Laxilef/GasholderMon/assets/6320S.pdf

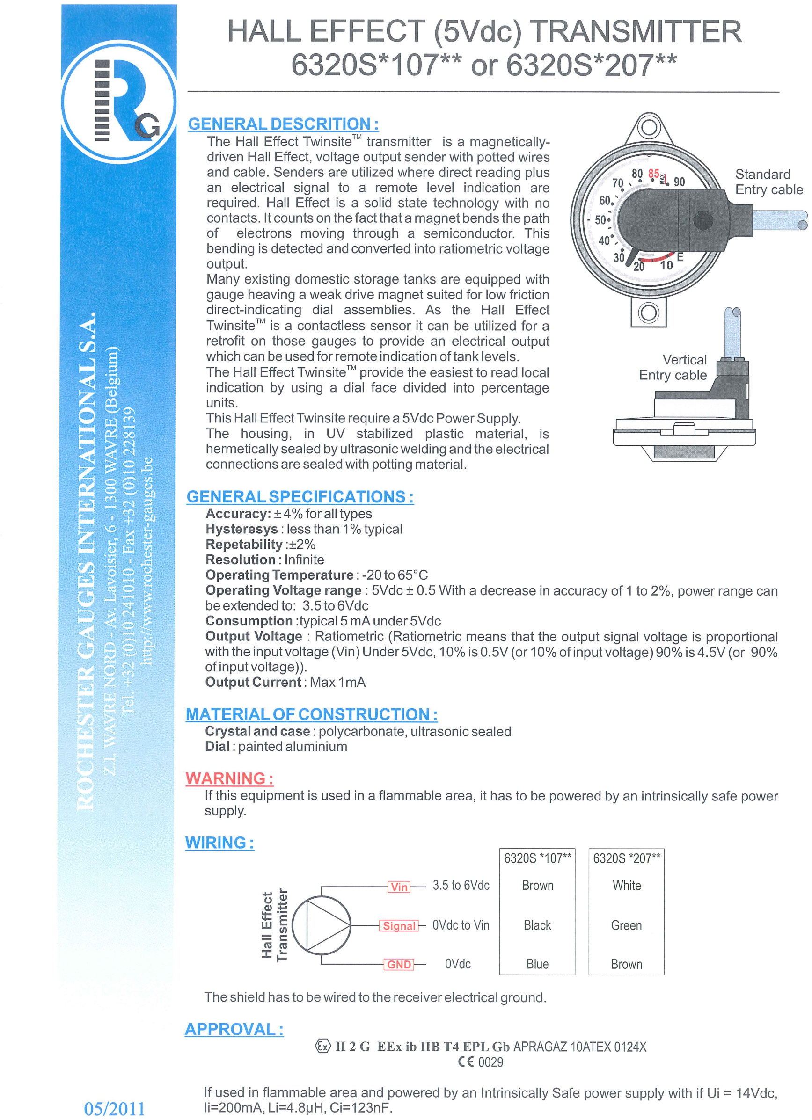
[picture p3: page 1]
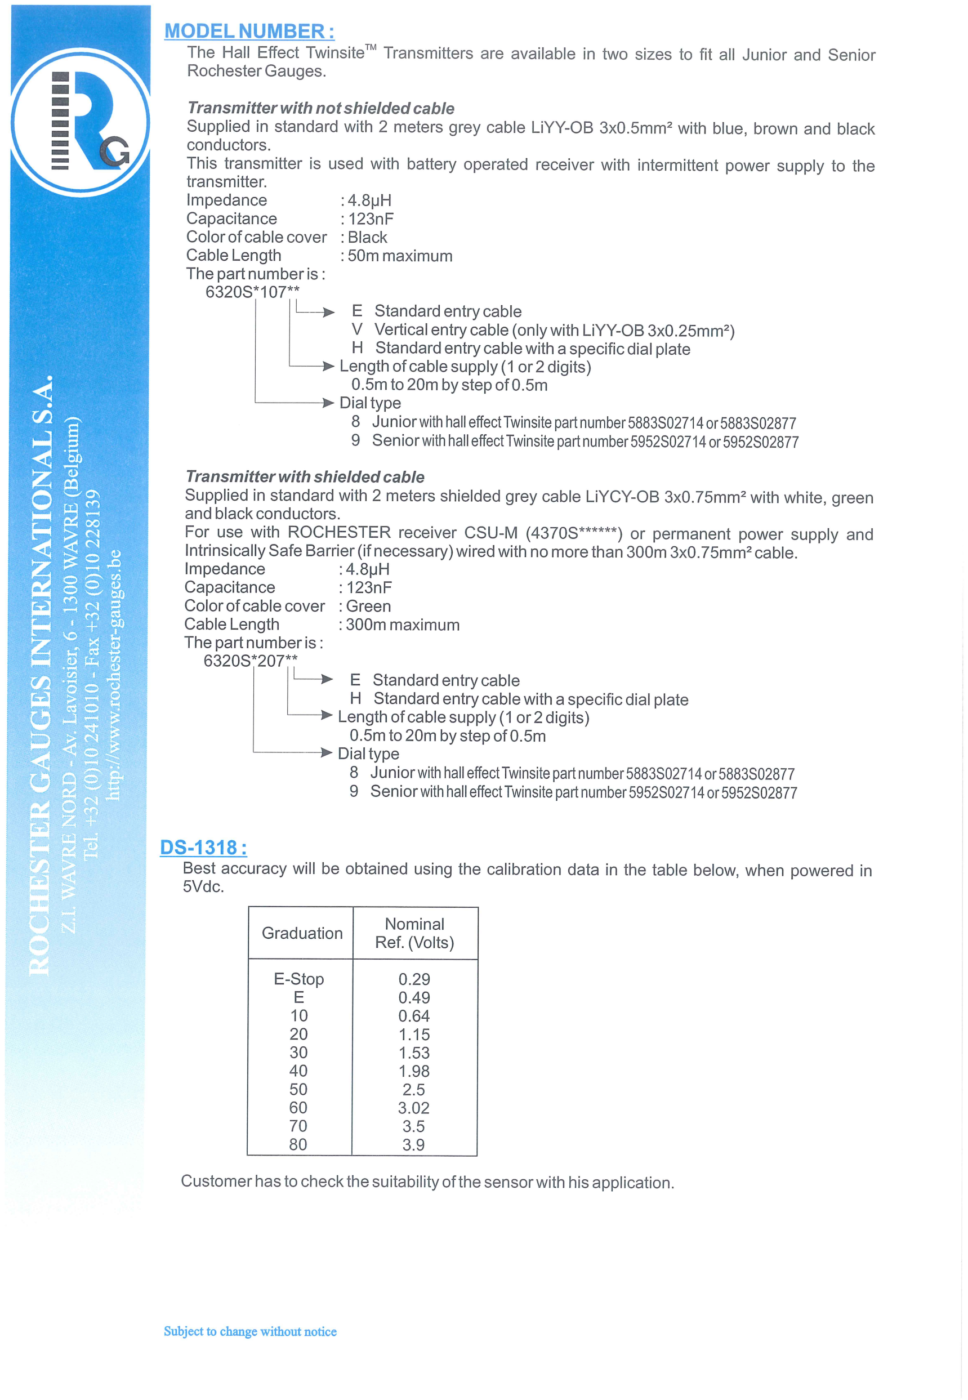
[picture p4: page 2]
