Laxilef/GasholderMon/assets/BOM.xlsx

ID | Name | Designator | Footprint | Quantity | Manufacturer Part
1 | 100uF | C1 | CAP-SMD_BD6.3-L6.6-W6.6-LS7.2-FD | 1 | RVT1C101M0605 | https://www.chipdip.ru/product0/9000565735
2 | 100nF | C2,C4,C5,C6,C7 | C0805 | 5 | GRM21BR71H104KA01L | https://www.chipdip.ru/product/grm21br71e104ka01l
3 | 22uF | C3 | CAP-SMD_BD5.0-L5.3-W5.3-LS6.3-FD | 1 | RVT1V220M0505 | https://www.chipdip.ru/product0/9000565721
4 | 0.5A | F1 | FUSE-7.4*4.5-5.1MM | 1 | TRC025 | https://www.chipdip.ru/product/vp4-1-0.5a
5 | MF-MSMF110/16-2 | F2 | F1812 | 1 | MF-MSMF110/16-2 | https://www.chipdip.ru/product0/8010600635
6 | MF-USMF005-2 | F3,F4 | F1210 | 2 | MF-USMF005-2 | https://www.chipdip.ru/product0/8003673517
7 | LED0805 | L1,L2,L3 | LED0805-RD | 3 | led0805 | https://www.chipdip.ru/product/to-2013bc-pg
8 | BSS138 | Q1,Q2 | SOT-23-3_L2.9-W1.3-P1.90-LS2.4-BR | 2 | BSS138 | https://www.chipdip.ru/product/bss138-umw
9 | IRLML5103TRPBF | Q3 | SOT-23_L2.9-W1.3-P1.90-LS2.4-BR | 1 | IRLML5103TRPBF | https://www.chipdip.ru/product/irlml5103trpbf-hottech
10 | 10k | R1,R2,R3,R4,R5,R6,R7,R8 | R0805 | 8 | 10kΩ | https://www.chipdip.ru/product/0.125w-0805-10-kom-1
11 | 100 | R9 | R0805 | 1 | 100Ω | https://www.chipdip.ru/product/0.125w-0805-100-om-1
12 | 1K | R10,R11,R12 | R0805 | 3 | RC0805FR-071KL | https://www.chipdip.ru/product/0.125w-0805-1-kom-1
13 | HLK-PM01 | U1 | PWRM-TH_HLK-PM01 | 1 | HLK-PM01 | https://www.chipdip.ru/product0/8000358621
14 | AMS1117-3.3 | U2 | SOT-223-3_L6.4-W3.5-P2.30-LS7.0-BR | 1 | AMS1117-3.3 | https://www.chipdip.ru/product/ams1117-3.3
15 | ADS1115IDGSR | U3 | MSOP-10_L3.0-W3.0-P0.50-LS5.0-BL | 1 | ADS1115IDGSR | https://www.chipdip.ru/product/ads1115idgst
16 | 300-021-1x | U5,U6 | ALMAS-SCREW-TERMINAL-300-021 | 2 | 300-021-12 | https://www.chipdip.ru/product/dg300-5.0-02p-12
17 | 300-031-1x | U7 | ALMAS-SCREW-TERMINAL-300-031 | 1 | 300-031-12 | https://www.chipdip.ru/product/dg300-5.0-03p-12
18 | B72210S2511K101 | VAR | RES-TH_L12.5-W8.0-P7.50-D0.8-S3.10 | 1 | B72210S2511K101 | https://www.chipdip.ru/product/b72210-s251-k101
