Laxilef/GasholderMon/assets/sheet.pdf

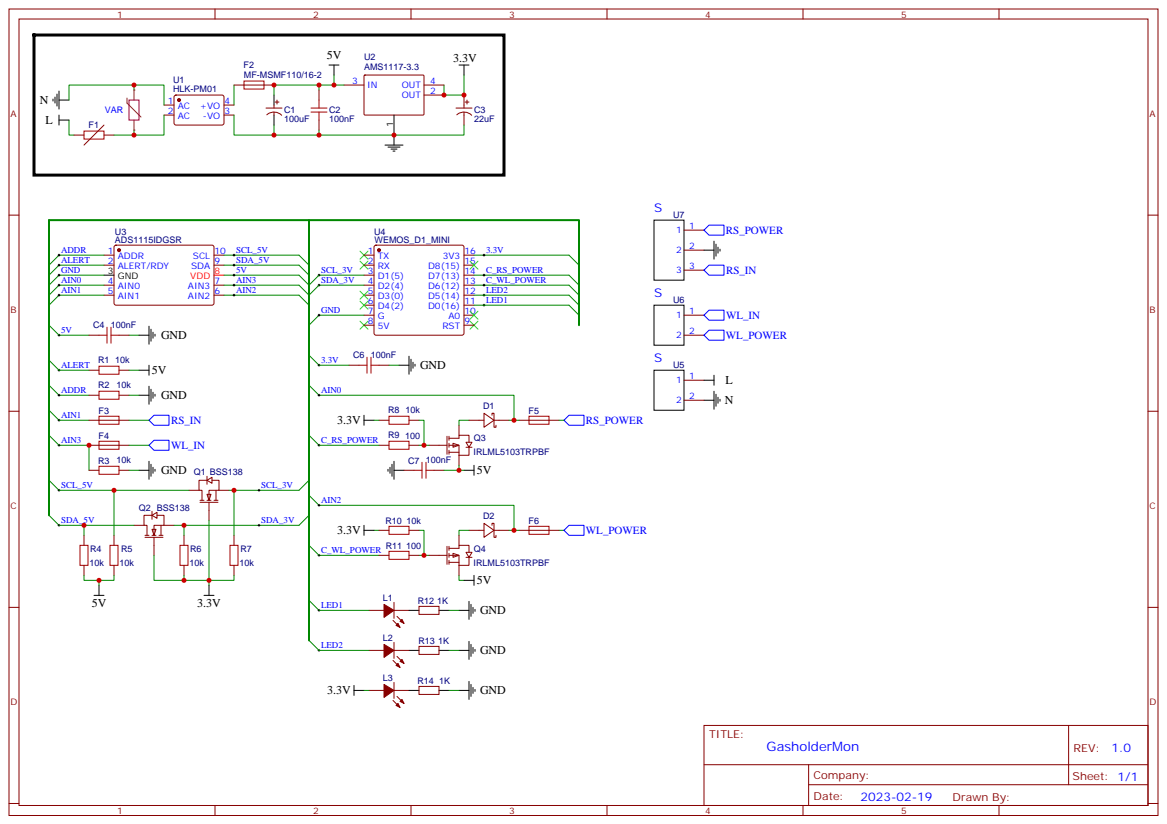
[picture p5: page 1]
