Laxilef/GasholderMon/(commit log)

2022-06-22 rename ino file, remaining sensor calibration map move to settings
2023-09-16 use platformio, more updates, added pcb
    [BOM.xlsx]
